UlrichFrank/lora_door_sensor/enclosure/test_C_base.stl

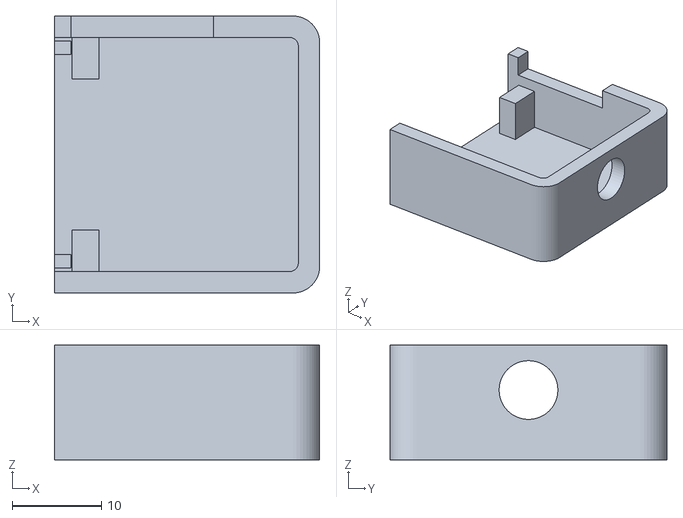
[picture p1: CAD file, 2026-10-27]
enclosure/test_C_base.stl
29.8 x 31.1 x 12.9
