UlrichFrank/lora_door_sensor/enclosure/test_B_base.stl

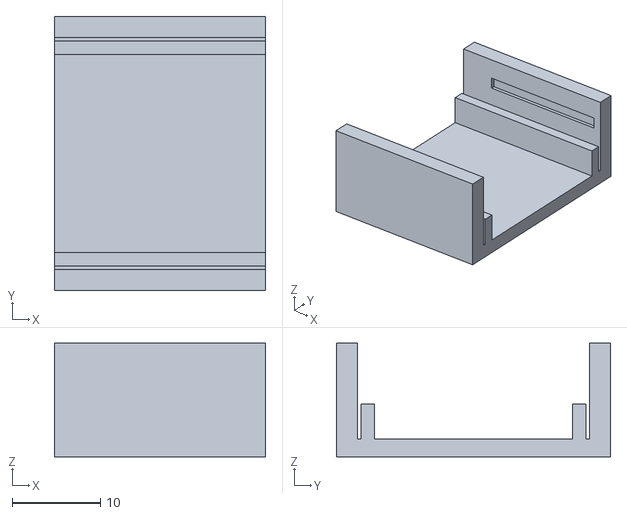
[picture p2: CAD file, 2026-10-27]
enclosure/test_B_base.stl
24.0 x 31.1 x 12.9
