UlrichFrank/lora_door_sensor/enclosure/template.stl

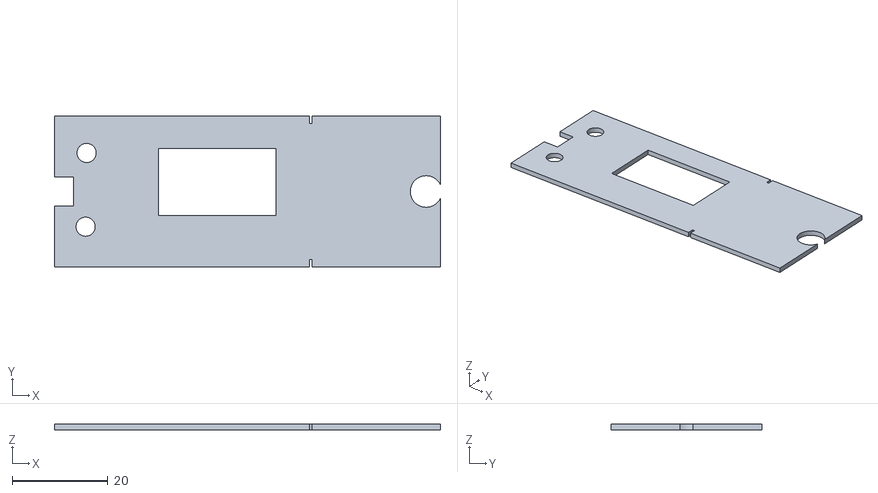
[picture p3: CAD file, 2026-10-27]
enclosure/template.stl
80.6 x 31.5 x 1.20
