UlrichFrank/lora_door_sensor/enclosure/test_B_lid.stl

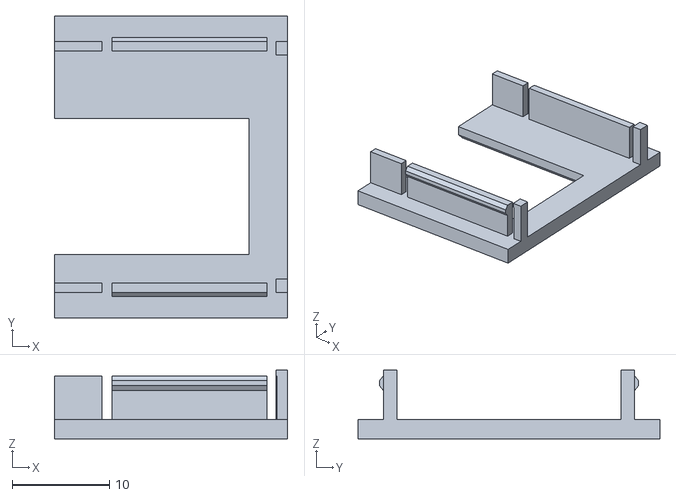
[picture p4: CAD file, 2026-10-27]
enclosure/test_B_lid.stl
24.0 x 31.1 x 7.10
