UlrichFrank/lora_door_sensor/enclosure/test_A_lid.stl

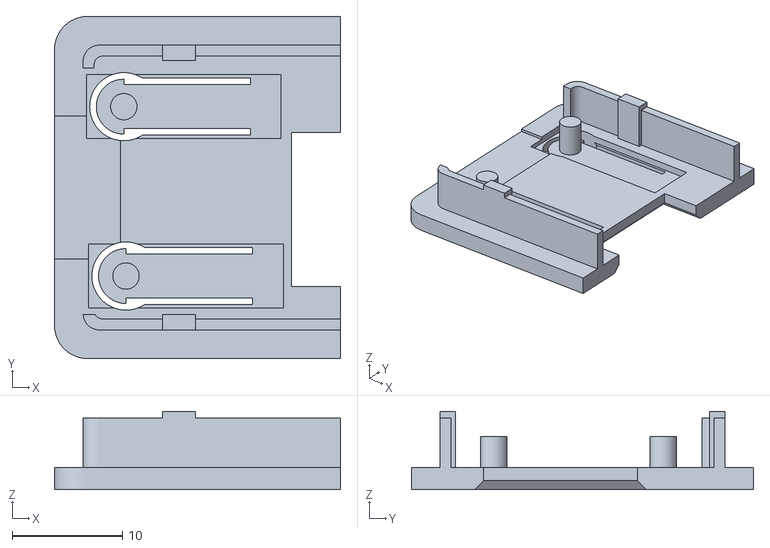
[picture p5: CAD file, 2026-10-27]
enclosure/test_A_lid.stl
26.0 x 31.1 x 7.10
