UlrichFrank/lora_door_sensor/enclosure/lid.stl

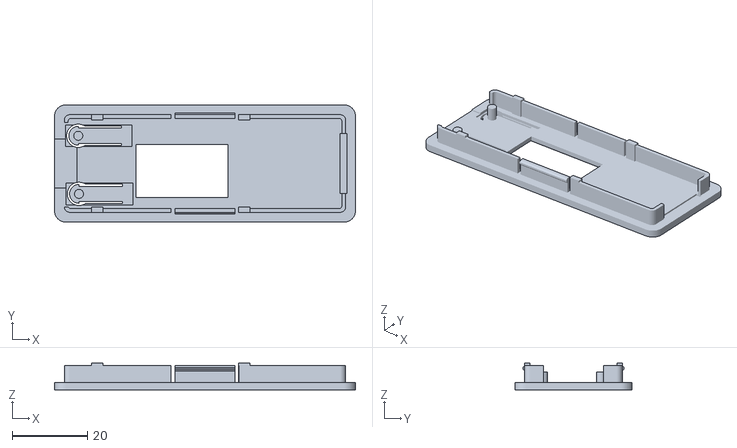
[picture p6: CAD file, 2026-10-27]
enclosure/lid.stl
79.8 x 31.1 x 7.10
