UlrichFrank/lora_door_sensor/enclosure/base.stl

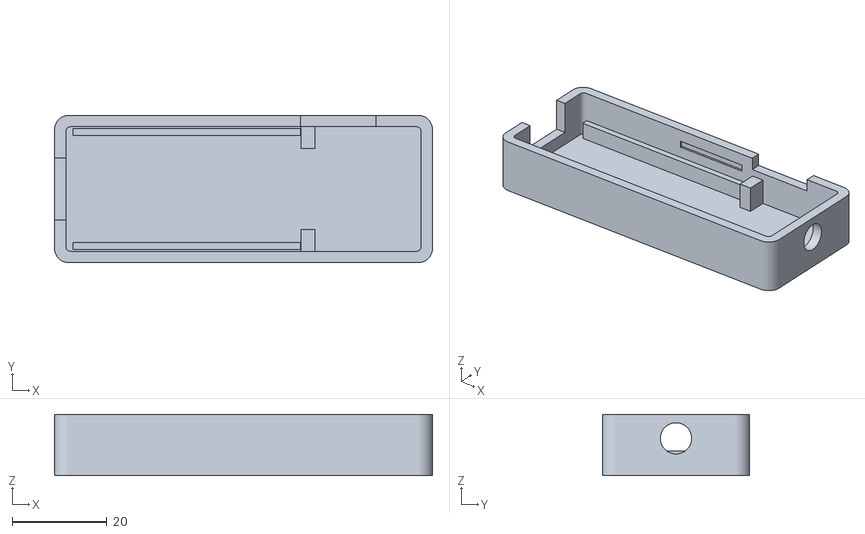
[picture p7: CAD file, 2026-10-27]
enclosure/base.stl
79.8 x 31.1 x 12.9
