UlrichFrank/lora_door_sensor/enclosure/test_C_lid.stl

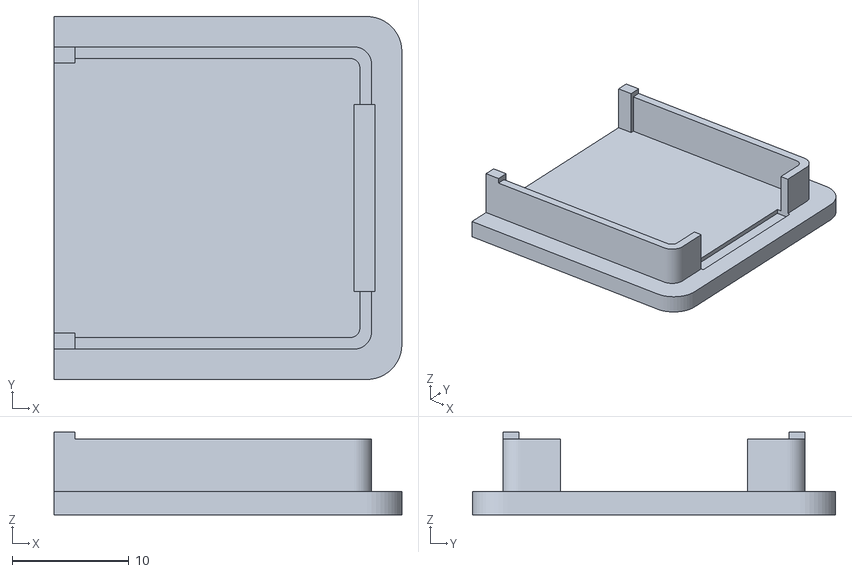
[picture p8: CAD file, 2026-10-27]
enclosure/test_C_lid.stl
29.8 x 31.1 x 7.10
