UlrichFrank/lora_door_sensor/enclosure/test_A_base.stl

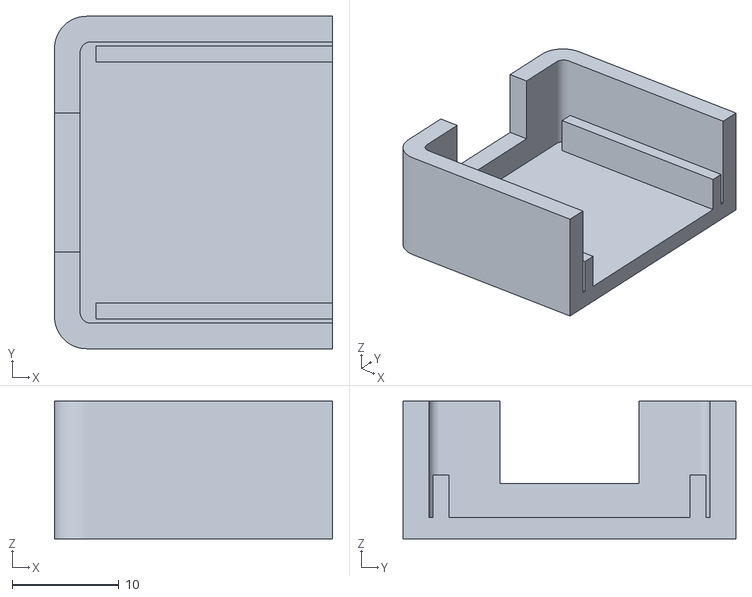
[picture p9: CAD file, 2026-10-27]
enclosure/test_A_base.stl
26.0 x 31.1 x 12.9
