UlrichFrank/lora_door_sensor/(commit log)

2026-10-25 feat: replace LoRaWAN sketch with ESPHome LoRa point-to-point link
    Garage node (reed + OLED, WiFi AP only) broadcasts encrypted LoRa to a
    base node that publishes retained JSON to MQTT: garage/door, garage/link,
    garage/node, garage/status. The OLED shows the live contact (Reed) next to
    the last state handed to the radio (Sent) and redraws on every change; the
    event rate limit is 3 s. Logs over MQTT are off by default and switched via
    garage/debug/set.
    Credentials are committed SOPS/age-encrypted (esphome/secrets.sops.yaml).
    The Arduino/ChirpStack sketch, Makefile and VS Code/Copilot files are gone;
    they remain in the history before this commit.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
    [heltec-v3.yaml]
2026-10-25 feat(enclosure): snap-fit case for the Heltec WiFi LoRa 32 V3
    Parametric OpenSCAD case (base, lid, fit-check template) with STL exports:
    display window over the active area, flexible printed PRG/RST buttons in the
    lid, USB-C opening, SMA bulkhead for an external antenna and an 18 mm cavity
    for the IPEX pigtail. The lid clicks in (two snap arms, no screws) and opens
    by hand via a pull tab. Dimensions from the Heltec V3.2 datasheet and photos.
    [base.stl, heltec_v3_case.scad, lid.stl, template.stl]
2026-10-25 enclosure: fix mirrored lid, add rails and end stop, close height over display, add test pieces
    [base.stl, heltec_v3_case.scad, lid.stl, test_A_base.stl, test_A_lid.stl, test_B_base.stl, test_B_lid.stl, test_C_base.stl]
2026-10-27 enclosure: add edge rails and end stop, lower SMA hole, longer antenna zone
    - edge rails (1.5 mm) and end stop on the PCB seat, stop 4.25 mm wide
    - SMA hole lowered, washer clearance 9.5 mm
    - antenna zone 24 mm (outer length 79.8 mm)
    - display gap 0.3 mm, lid 2.0 mm with beveled window
    - remove lid pull tab, keep snap noses, grooves and slits
    - test pieces re-sliced, STLs regenerated
    [base.stl, heltec_v3_case.scad, lid.stl, template.stl, test_A_base.stl, test_A_lid.stl, test_B_base.stl, test_B_lid.stl]
